vthinh-la/smart-agriculture-iot-system/hardware/pinouts/esp32_pinout.pdf

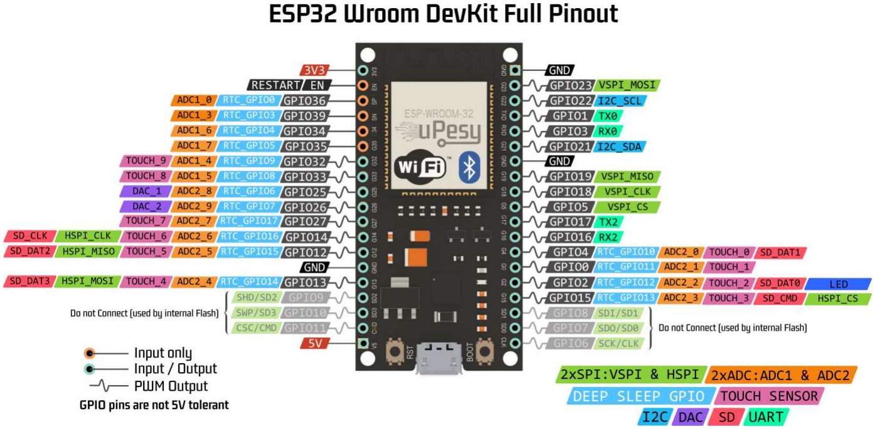
[picture p9: figure]
