vthinh-la/smart-agriculture-iot-system/hardware/pinouts/nrf24_pinout.pdf

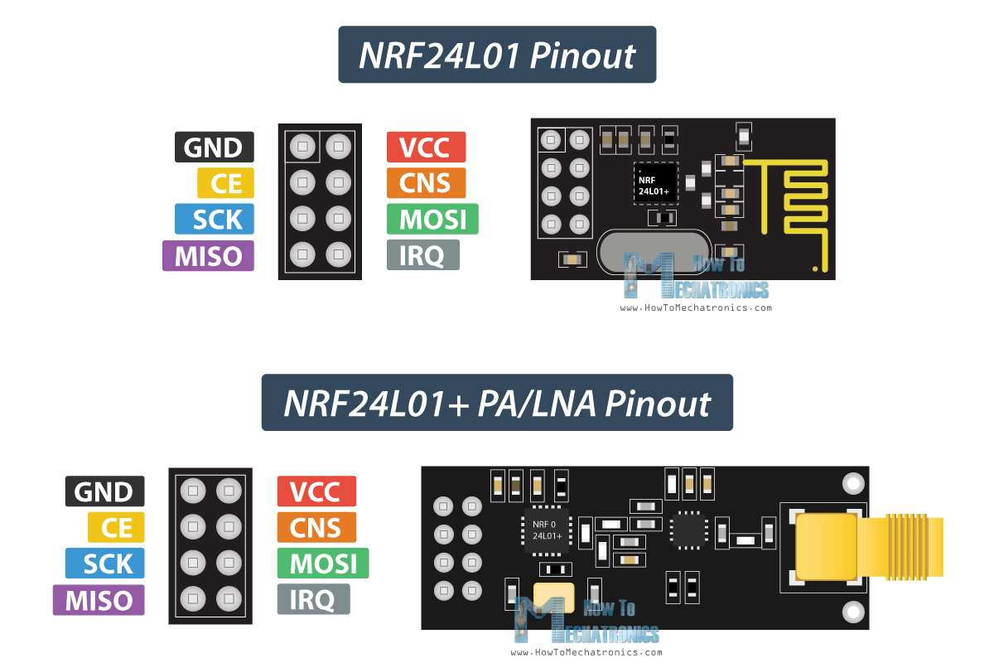
[picture p10: page 1]
