vthinh-la/smart-agriculture-iot-system/hardware/schematics/pdf/Atmega8_schematic.pdf

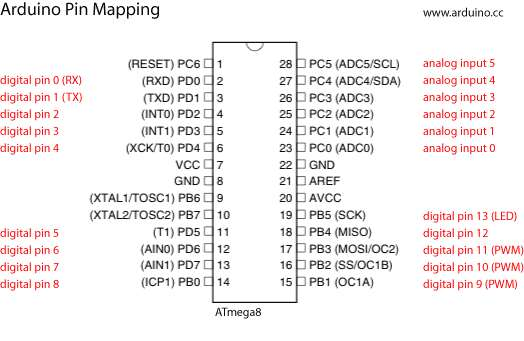
[picture p11: page 1]
