vthinh-la/smart-agriculture-iot-system/docs/images/gateway_3d_render.png

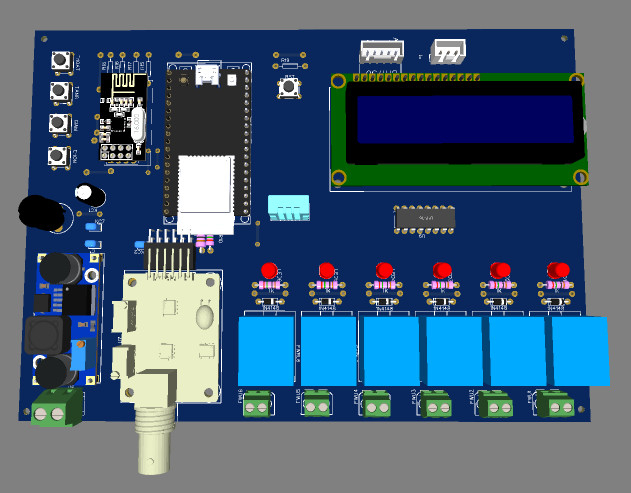
docs/images/gateway_3d_render.png
