vthinh-la/smart-agriculture-iot-system/docs/images/gateway_pcb_bottom.png

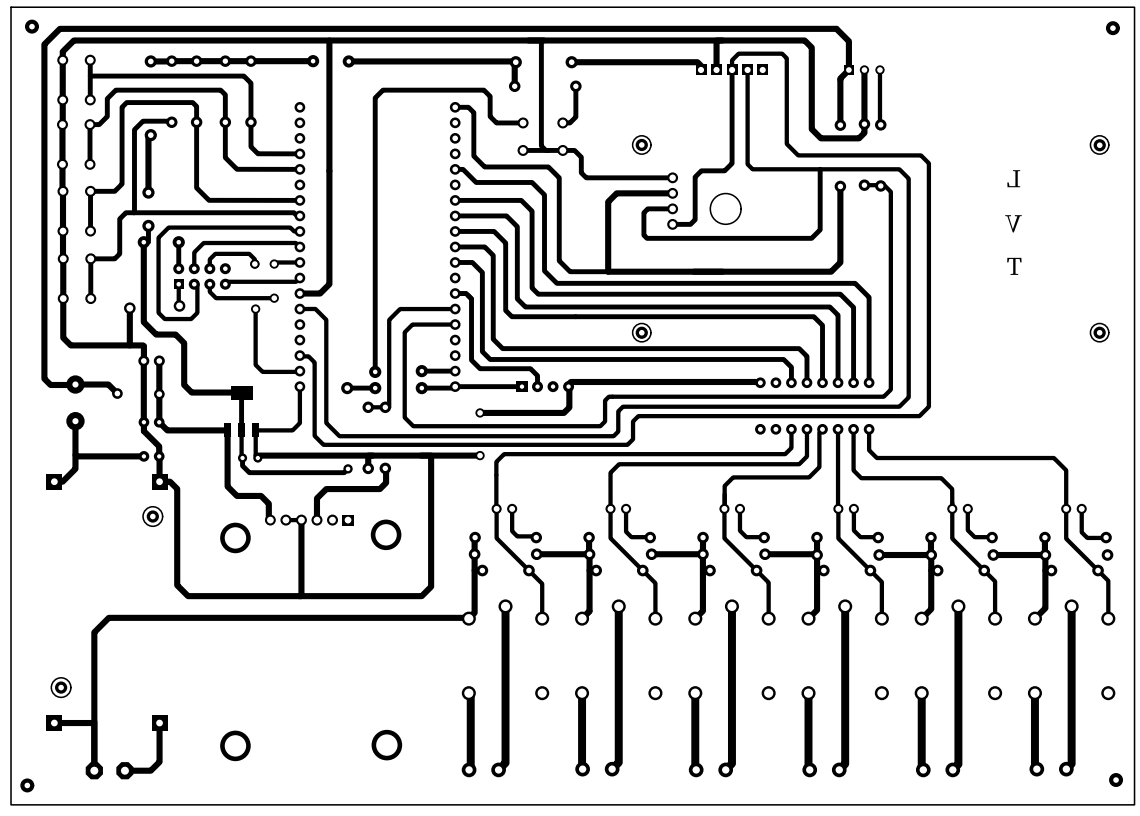
docs/images/gateway_pcb_bottom.png
