vthinh-la/smart-agriculture-iot-system/docs/images/gateway_pcb_top.png

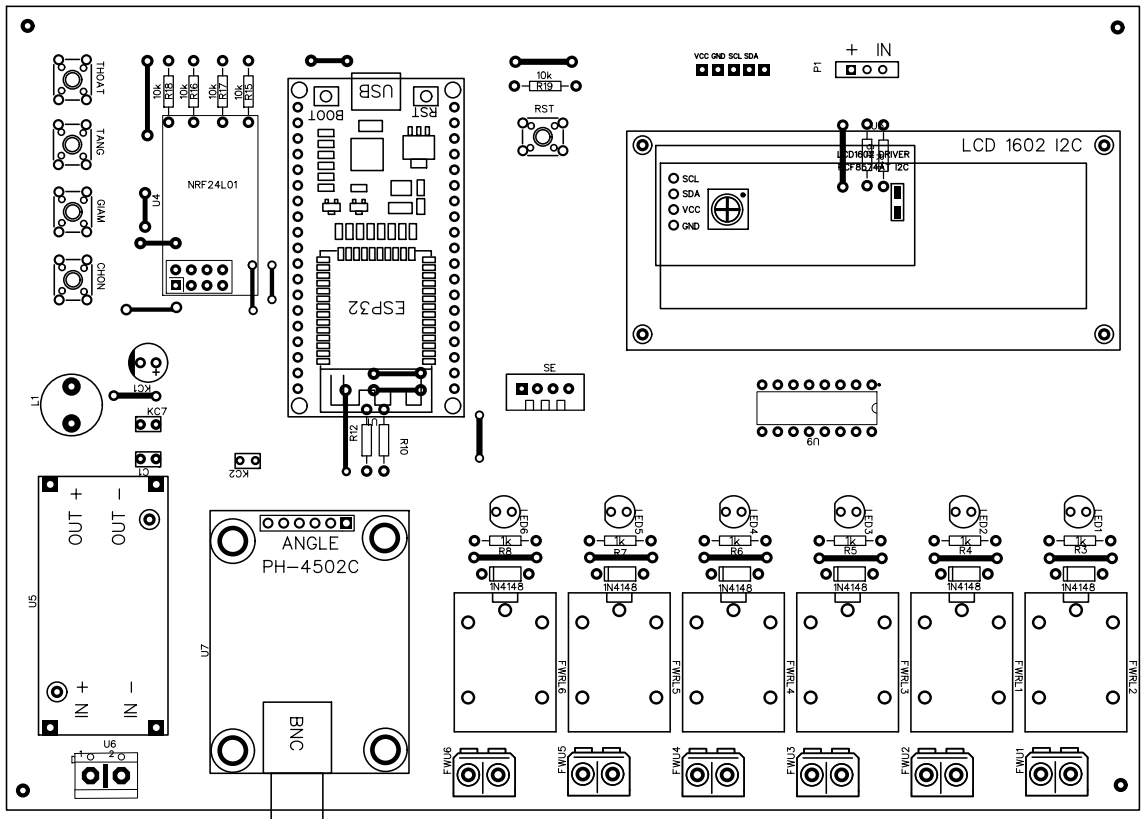
docs/images/gateway_pcb_top.png
