vthinh-la/smart-agriculture-iot-system/docs/images/nrf24_module_pinout.png

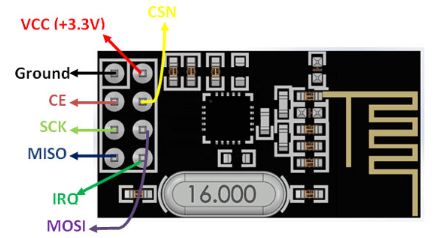
docs/images/nrf24_module_pinout.png
