vthinh-la/smart-agriculture-iot-system/docs/images/nrf24_schematic.png

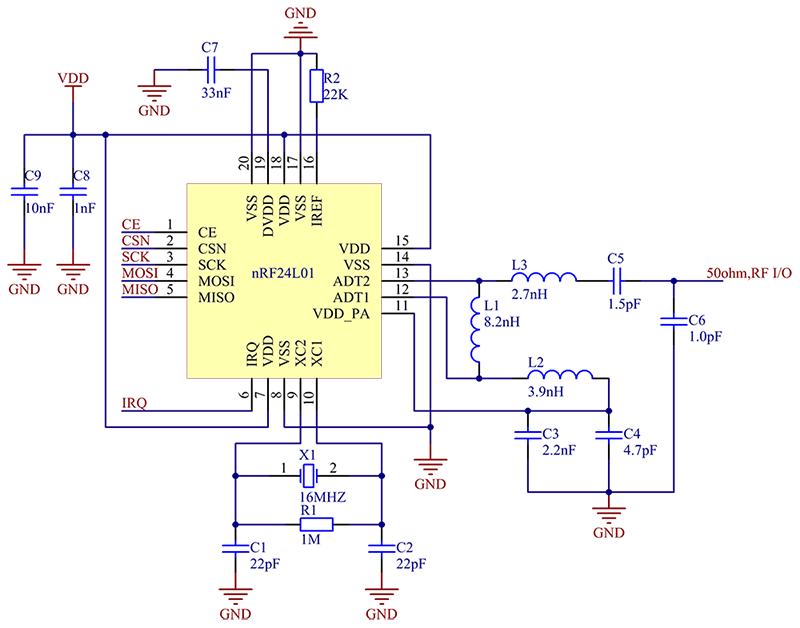
docs/images/nrf24_schematic.png
