vthinh-la/smart-agriculture-iot-system/hardware/pinouts/Cau_Phan_Ap_Analog.jpg

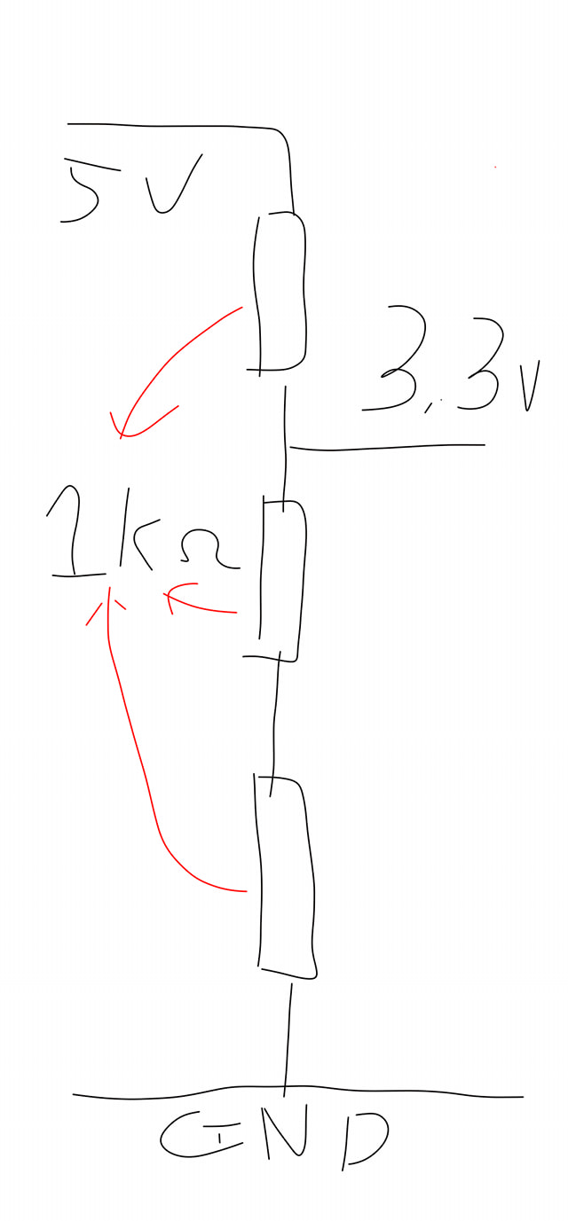
hardware/pinouts/Cau_Phan_Ap_Analog.jpg
