vthinh-la/smart-agriculture-iot-system/hardware/pinouts/Mach_Chong_Nhieu.bmp

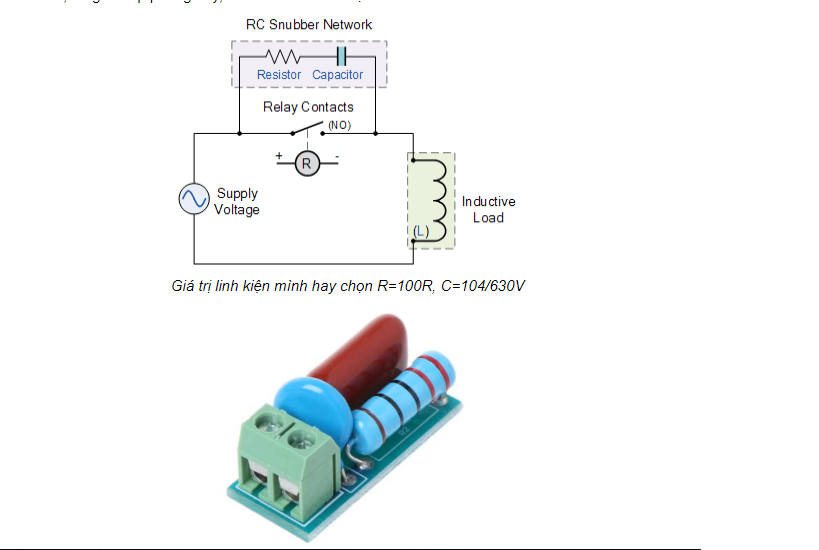
hardware/pinouts/Mach_Chong_Nhieu.bmp
