vthinh-la/smart-agriculture-iot-system/hardware/pinouts/MQ135-Sensor-Pinout.jpg

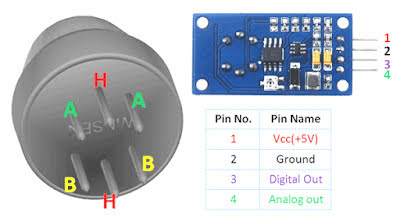
hardware/pinouts/MQ135-Sensor-Pinout.jpg
