vthinh-la/smart-agriculture-iot-system/mechanical/3d_models/node_enclosure/RF-nano_case_mysensors.org_light-baro_-_BOTTOM.png

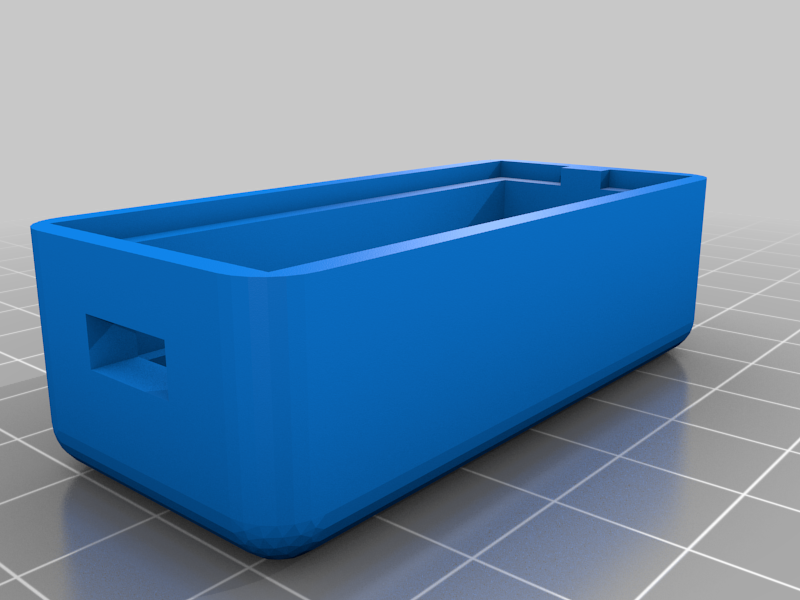
mechanical/3d_models/node_enclosure/RF-nano_case_mysensors.org_light-baro_-_BOTTOM.png
