vthinh-la/smart-agriculture-iot-system/mechanical/3d_models/node_enclosure/RF-nano_case_mysensors.org_light-baro_TOP.png

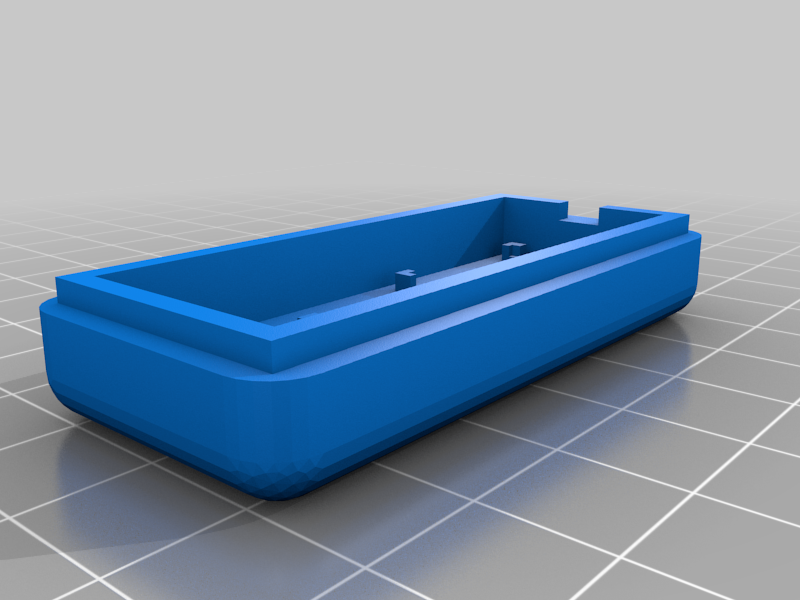
mechanical/3d_models/node_enclosure/RF-nano_case_mysensors.org_light-baro_TOP.png
