vthinh-la/smart-agriculture-iot-system/mechanical/3d_models/gateway_enclosure/Gateway_Box.3mf

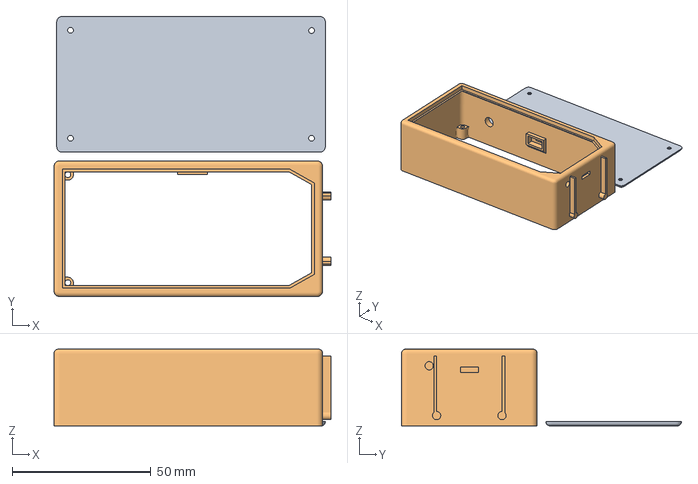
[picture p22: CAD file, 2026-10-18]
mechanical/3d_models/gateway_enclosure/Gateway_Box.3mf
100.0 x 101.1 x 27.7 mm
Nắp Hộp.stl
Hộp.stl
