vthinh-la/smart-agriculture-iot-system/mechanical/3d_models/sensor_brackets/BH1750_Body.stl

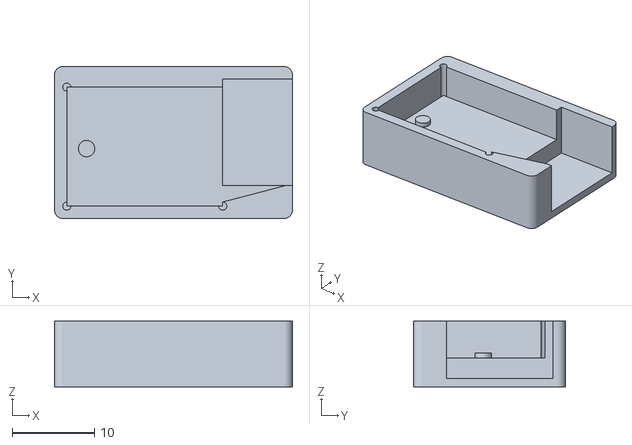
[picture p24: CAD file, 2026-10-18]
mechanical/3d_models/sensor_brackets/BH1750_Body.stl
29.0 x 18.5 x 8.00
