vthinh-la/smart-agriculture-iot-system/mechanical/3d_models/node_enclosure/RF-nano_case_mysensors.org_light-baro_TOP.stl

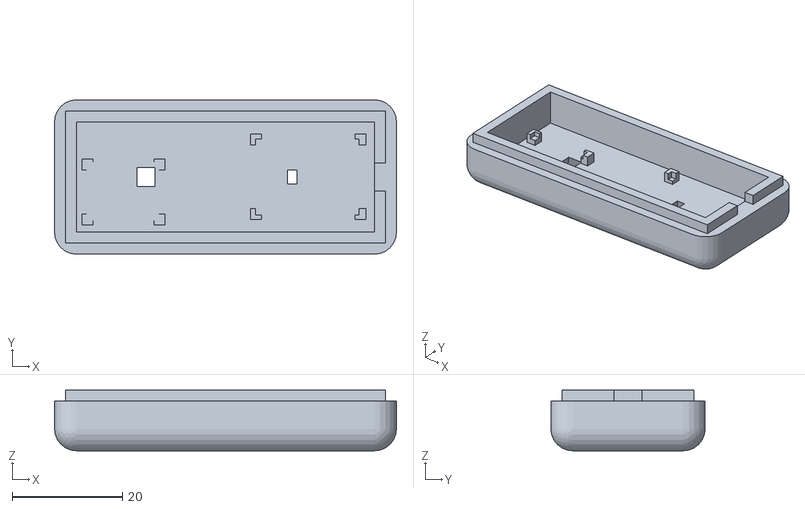
[picture p25: CAD file, 2026-10-18]
mechanical/3d_models/node_enclosure/RF-nano_case_mysensors.org_light-baro_TOP.stl
62.0 x 28.0 x 11.0
