vthinh-la/smart-agriculture-iot-system/mechanical/3d_models/sensor_brackets/BH1750_Lid.stl

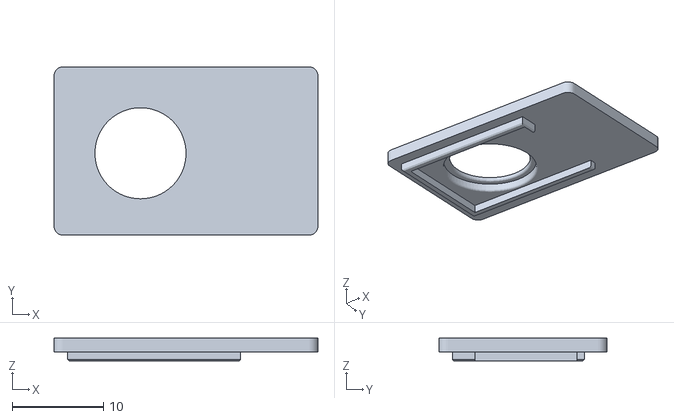
[picture p26: CAD file, 2026-10-18]
mechanical/3d_models/sensor_brackets/BH1750_Lid.stl
29.0 x 18.5 x 2.50
