vthinh-la/smart-agriculture-iot-system/mechanical/3d_models/sensor_brackets/De_Cam_Bien_Anh_Sang.stl

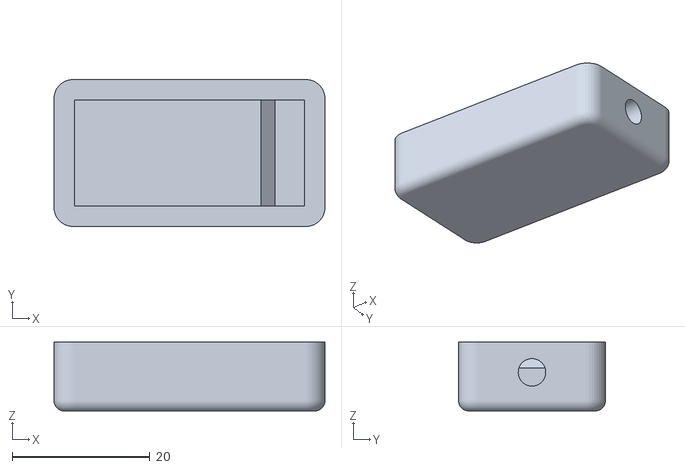
[picture p27: CAD file, 2026-10-18]
mechanical/3d_models/sensor_brackets/De_Cam_Bien_Anh_Sang.stl
39.3 x 21.3 x 10.0
