vthinh-la/smart-agriculture-iot-system/mechanical/3d_models/sensor_brackets/MQ_Gas_Sensor_Cover.stl

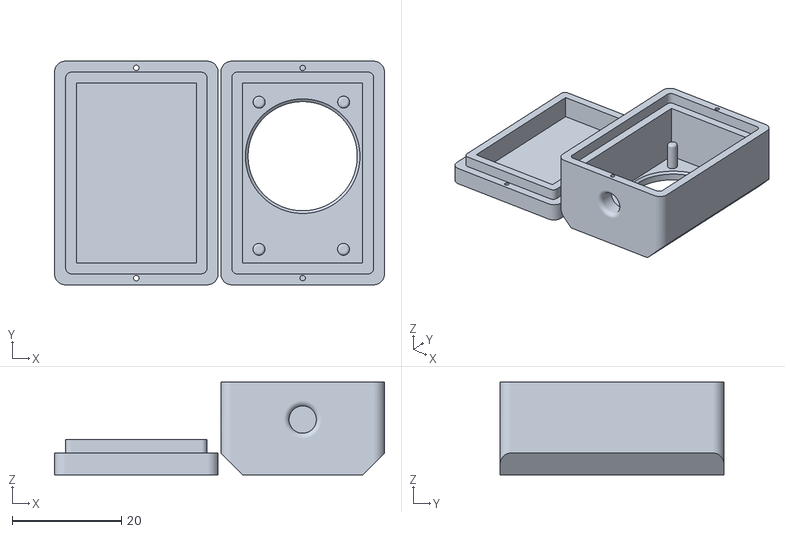
[picture p28: CAD file, 2026-10-18]
mechanical/3d_models/sensor_brackets/MQ_Gas_Sensor_Cover.stl
60.5 x 41.0 x 17.0
