vthinh-la/smart-agriculture-iot-system/(list of files, cad)

Other CAD files:
mechanical/3d_models/gateway_enclosure/Gateway_Lid.3mf
mechanical/3d_models/gateway_enclosure/Gateway_Box.stl
mechanical/3d_models/gateway_enclosure/Gateway_Lid.stl
