vthinh-la/smart-agriculture-iot-system/SO_DO_MACH/NODE/PCB_PCB_ATMEGA8-NRF24-TEST_2026-10-19.pdf

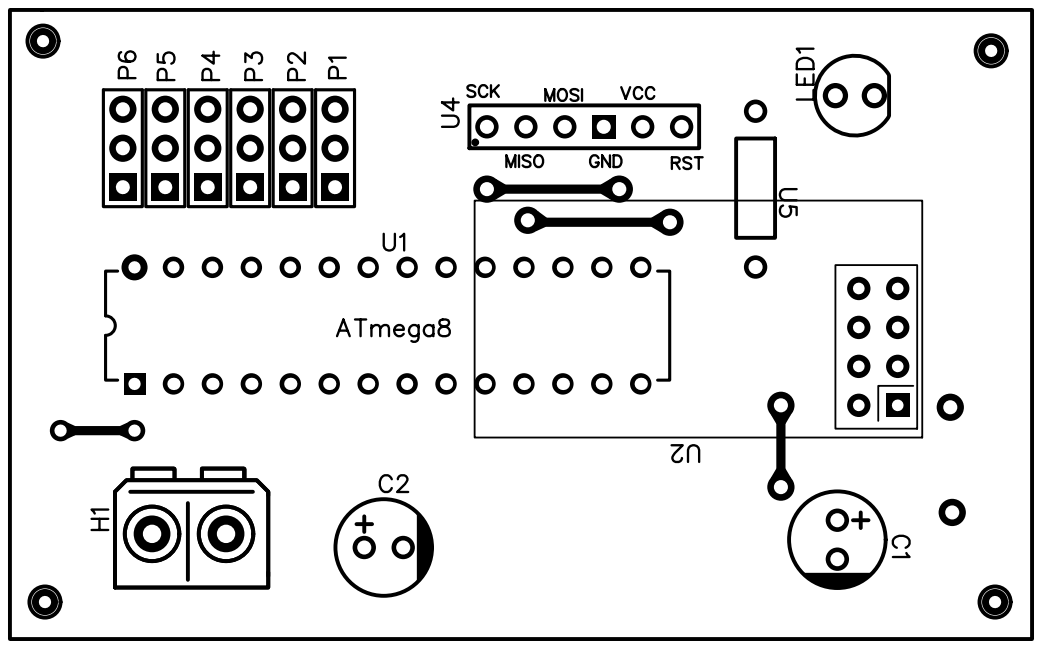
[picture p33: page 1]
