vthinh-la/smart-agriculture-iot-system/hardware/pcb/etch_masks_pdf/PCB_Mach_Sever_Etch_Mask.pdf

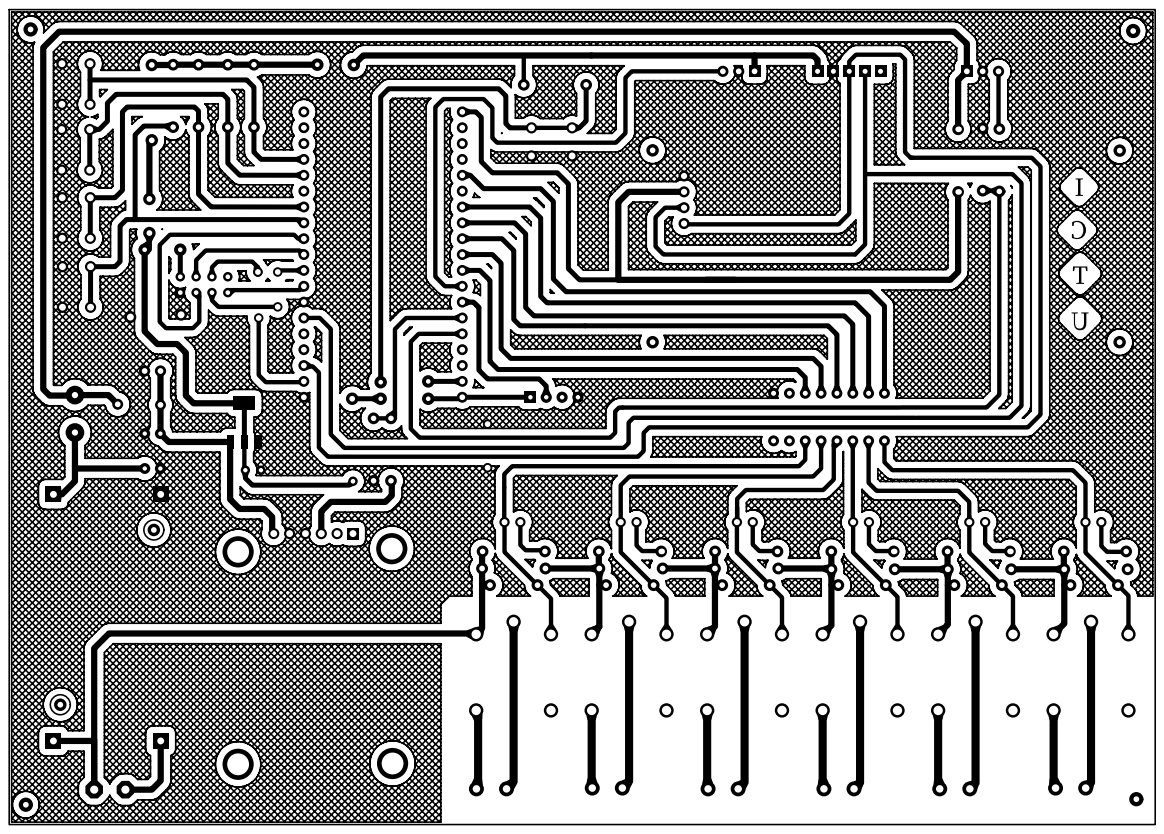
[picture p34: page 1]
