vthinh-la/smart-agriculture-iot-system/(list of files, drawings)

Other design files:
hardware/pcb/easyeda/PCB_PCB_ATMEGA8-NRF24-TEST_2026-06-16.json
hardware/pcb/easyeda/PCB_PCB_Mach-Sever-copy_2026-06-16.json
hardware/pcb/sprint_layout/Gateway_Server.lay6
hardware/pcb/sprint_layout/Sensor_Node.lay6
hardware/schematics/easyeda/SCH_ATMEGA8-NRF24-TEST_2026-06-16.json
hardware/schematics/easyeda/SCH_Mach-Sever-su-dung-nut-nhan_2026-06-16.json
