vthinh-la/smart-agriculture-iot-system/(commit log)

2026-10-18 feat: complete open-source hardware, firmware, CAD, and technical documentation
    [BH1750_Body.stl, BH1750_Lid.stl, De_Cam_Bien_Anh_Sang.stl, Gateway_Box.3mf, Gateway_Box.stl, Gateway_Lid.3mf, Gateway_Lid.stl, Gateway_Server.lay6]
2026-10-18 docs: enrich technical documentation with hardware diagrams, PCB layouts, deployment photos, and user guide
2026-10-18 fix(hardware,docs): integrate official SO_DO_MACH schematics and correct BOM/wiring inaccuracies
    [VER_2.1_CONFIG_WIFI.ino, main.cpp, node01_soil_moisture.ino]
