vthinh-la/smart-agriculture-iot-system/(notices)

Notices in the files:
README.md:
License: MIT
